hydronyme/trr2026/report/build_report/img/imageESP32-pinout-simple.png

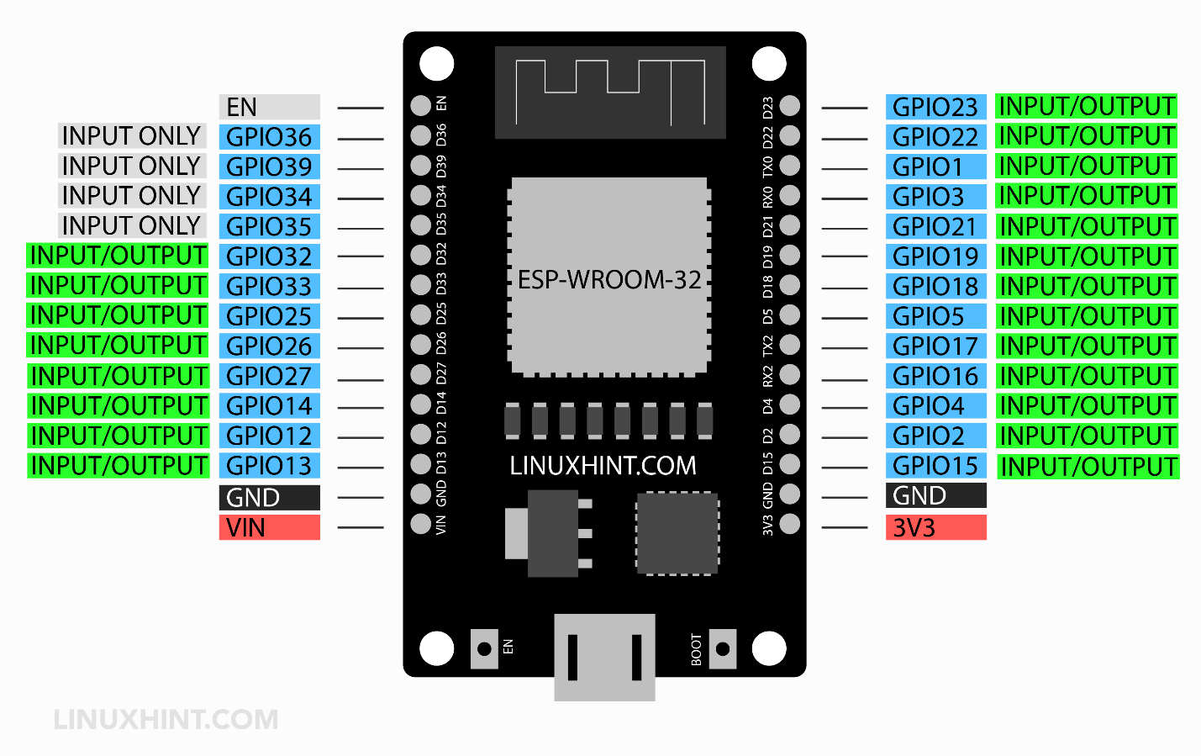
report/build_report/img/imageESP32-pinout-simple.png
