hydronyme/trr2026/report/build_report/img/L298N-DRIVER-pinout.jpg

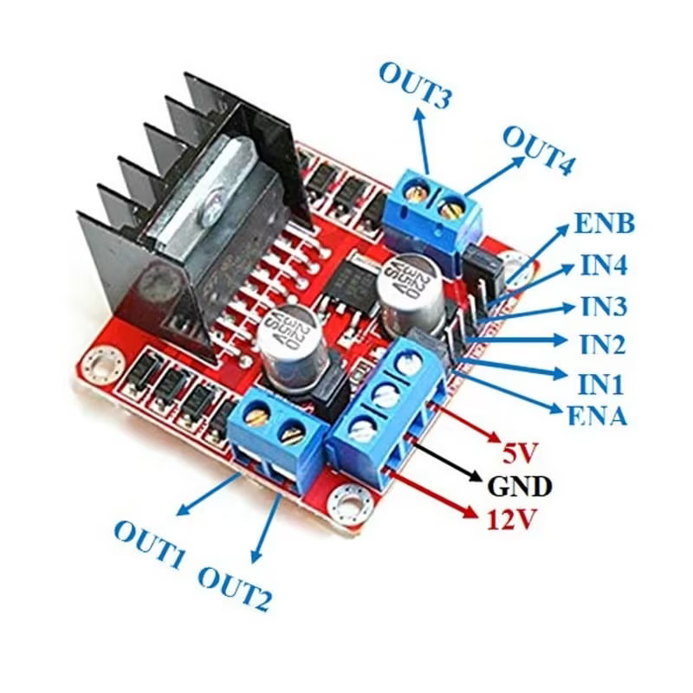
report/build_report/img/L298N-DRIVER-pinout.jpg
