hydronyme/trr2026/report/build_report/img/L298N-DRIVER-pinout.png

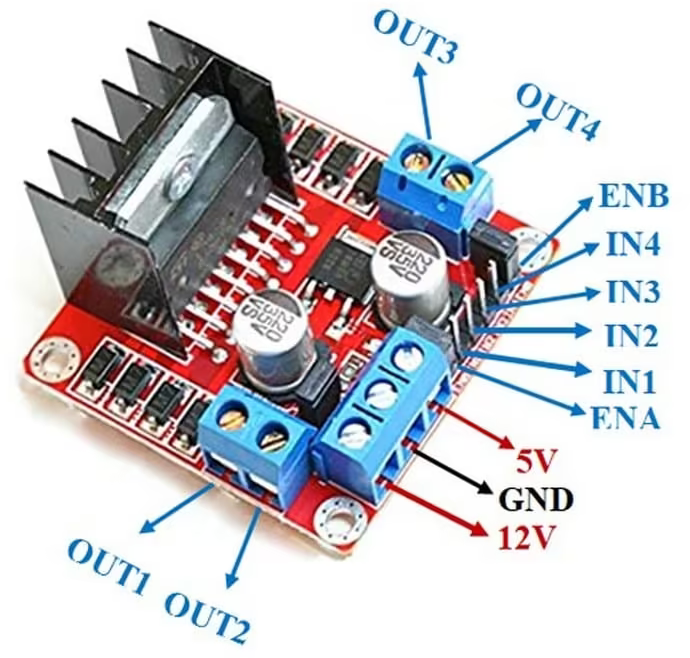
report/build_report/img/L298N-DRIVER-pinout.png
