hydronyme/trr2026/report/build_report/plan-projet.html

tout déplier

to do list

- programme de démarrage normal
- pilotage du pont H
- plaque de séparation et le positionnement de la caméra
- calculer l'homographie de la caméra
- carénage de la caméra
- carrenage de la voiture
- vérification mécanique de la direction rectiligne de la voiture
- utilisation de l'intelligence artificielle pour lire la ligne
- utilisation de l'intelligence artificielle pour les trajectoires dans les courbes.

done

- programme de démarrage via web
- programme d'arrêt via web
- piloter la vitesse via web

1. Conception générale de la voiture

Les composants à prendre en compte sont :

1. batterie propulsion 7,2V
2. moteur 7V ?
3. point H pour commande moteur
4. servo moteur 7V
5. compte tours 5V à 12V
6. esp32
7. batterie pour jetson orin nano 19V
8. régulateur de tension pour la jetson
9. jetson orin nano 19V



La dimension de plaque supérieure est 21.8 x 13.6

les composants de la voiture sont divisés en une partie basse et une partie haute

Dans la partie basse, on trouve la partie mécanique les composantes de propulsion et de direction

Dans la partie haute, on trouve la partie intelligente de la voiture.

2. Composants électroniques du niveau bas

2.1 Batterie moteur 7.2 V

Batterie 2S 7.2V Nimh

2.2 Servo Moteur pour la commande de direction : Hitec D-625MW HV

Dans la version initiale, le servo moteur était un KONECT 0913 LVMG 55G/9KG qui nécessitait une alimentation en 5V. Afin d'éviter un transformateur, il a été remplacé par un servo qui accepte directement la tension de la batterie 7,2 V.

2.2.1 Caractéristiques servo SRT Standard Servo (CL6030)

link (https://www.flashrc.com/fr/servos-rc-precision-fiabilite-pour-modelisme/24020-servo-digital-standard-hitec-d-625mw-hv-60g-10kgcm-013s-60-669962366250.html)
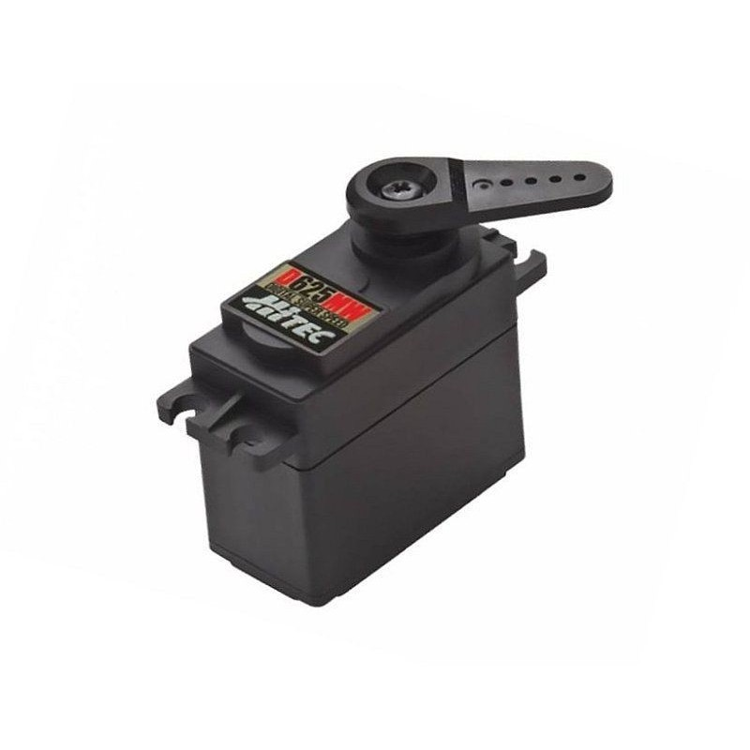
[picture p5: report/build_report/img/servo-digital-standard-hitec-d-625mw-hv-60g-10kgcm-013s-60.jpg]


Les servos ultra-rapides HS D-625MW HITEC D-Series offrent la plus haute résolution sur le marché aujourd'hui. Les meilleures possibilités de réponse et de programmation sont réalisées grâce au MCU 32 bits et à la technologie ADC 12 bits.La série 'D' regroupe les servos HITEC fonctionnant aussi bien en tension classique (4,8/6V) que HV (8,4V). Vous pourrez donc l'alimenter comme vous le souhaitez.Le servo numérique HS-625MW Digital est entièrement programmable et offre une bonne durabilité grâce à ses robustes engrenages en acier complets et à deux roulements à billes sur l'arbre de sortie, ce qui convient particulièrement lorsque le jeu faible et la haute précision de positionnement sont importants.La longue durée de vie et la transmission conçue de manière unique en font l'un des servos les plus fiables et les plus efficaces du marché.

Caractéristiques :

- Largeur: 20 mm
- Hauteur: 37 mm
- Longueur: 40 mm
- Poids: 60 gr
- Type de servo: standard
- Caractéristiques spéciales: large-tension numérique
- Type de moteur Servos: coreless
- Équipement: acier
- Tension de fonctionnement en V: 4.8-8.4 V
- Temps de fonctionnement s / 60 ° à 4,8 volts: 0,20
- Temps de fonctionnement s / 60 ° à 6,0 volts: 0,15
- Temps de fonctionnement s / 60 ° à 7.4 volts: 0.13
- Couple en kgcm à 4,8 volts: 6.3
- Couple en kgcm à 6,0 volts: 8.8
- Couple en kgcm à 7,4 volts: 10
- Denture: 25T
- Roulement à billes: oui
- Étanche: non

2.2.2 connexion Jetson

Signal PWM requis

Le servo standard attend :

Fréquence : 50 Hz (Période = 20 ms)

Impulsion :

~1 ms → 0°
~1.5 ms → 90°
~2 ms → 180°

code esp32

#include 

static const int servoPin = 18;

Servo servo1;

void setup() {

  Serial.begin(115200);
  servo1.attach(servoPin);
}

void loop() {
  for(int posDegrees = 0; posDegrees <= 180; posDegrees++) {
    servo1.write(posDegrees);
    Serial.println(posDegrees);
    delay(20);
  }

  for(int posDegrees = 180; posDegrees >= 0; posDegrees--) {
    servo1.write(posDegrees);
    Serial.println(posDegrees);
    delay(20);
  }
}

code jetson

import serial
import time

ser = serial.Serial('/dev/ttyUSB0', 115200)
time.sleep(2)

def set_angle(angle):
    cmd = f"{angle}\n"
    ser.write(cmd.encode())

set_angle(0)
time.sleep(2)
set_angle(90)
time.sleep(2)
set_angle(180)

2.3 Compte-tours

OMRON E6A2-CWZ3C Rotary Encoder.

- Red 5 to 12 V DC
- Black : 0V
- White: OUT A
- Green : OUT B
- Yellow : OUT Z

compte tours (https://www.ia.omron.com/product/item/2368/)

Rotary Encoder, Incremental, External Diameter: 25 dia., NPN open collector output, 200 P/R, 5 to 12 VDC, Phases A/B/Z, Pre-wired model, 2 m

2.4 Pilotage du moteur avec un Pont-H : BTS7980

Initialement, le pont H utilisé était un L298N mais l'intensité maximale de ce driver est limité à 2A, une valeur insuffisante pour le moteur qui peut tirer jusqu'à 10A.

Le pont en H BTS7980 permet de piloter un moteur qui nécessite beaucoup de courant. Cette carte est composée de 2 demi-pont en H BTS7960 qui permettent de supporter un courant jusqu'à 43A sous une tension entre 5,5V et 27V. Les signaux de commandes sont isolés par un 74HC244 et ce qui permet de le piloter aussi bien en 3,3V ou en 5V

Pin | Nom | Fonction
1 | RPMW | Forward Level, PWM signal actif à l'état haut
2 | LPWM | Reverse Level, PWM signal actif à l'état haut
3 | R_EN | Forward Enable, signal actif à l'état haut
4 | L_EN | Reverse Enable, signal actif à l'état haut
5 | R_IS | Forward Drive, sortie Alarme consommation
6 | L_IS | Reverse Drive, sortie Alarme consommation
7 | VCC | Alimentation +5V
8 | GND | Masse

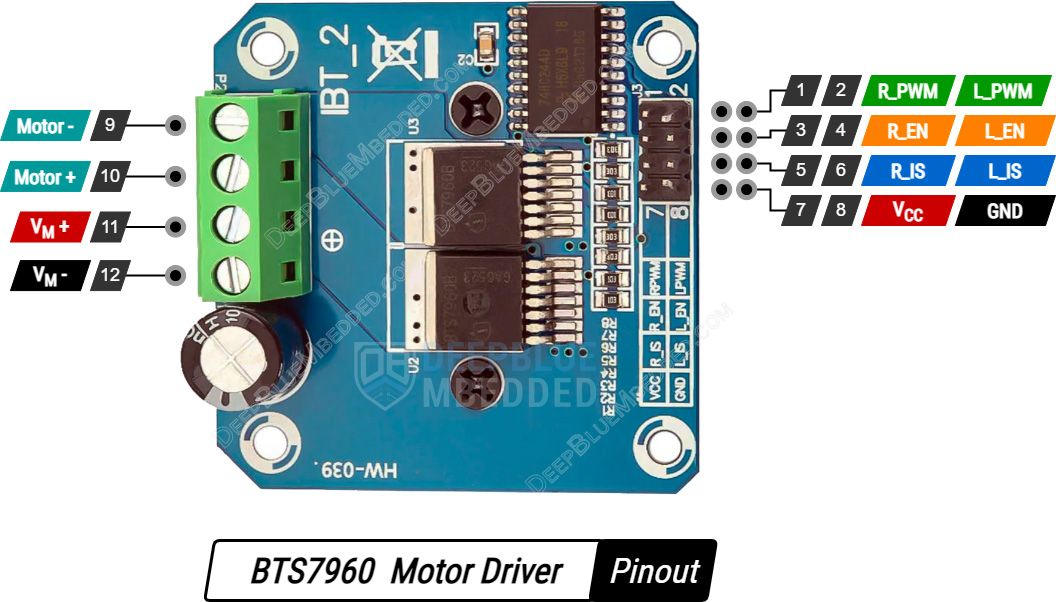
[picture p6: report/build_report/img/TBS7960-Pinout.jpg]


PIN 1 | PIN 2 | PINS 3 & 4 | Motor Output
PWM (20 kHz, 3.3V amplitude) | 0 volts | 3.3 volts | Variable speed Forward
0 volts | PWM (20 kHz, 3.3V amplitude) | 3.3 volts | Variable speed Reverse

2.4.1 Connexion entre L298N et ESP32

Connexion

L298N | ESP32
ENA | GPIO PWM (ex: 25)
IN1 | GPIO (ex: 26)
IN2 | GPIO (ex: 27)
GND | GND commun

Logique de commande

IN1 | IN2 | Action
1 | 0 | Sens 1
0 | 1 | Sens 2
0 | 0 | Stop
1 | 1 | Frein

Code Jetson

import serial
ser = serial.Serial('/dev/ttyUSB0', 115200)

ser.write(b'F100\n')  # Forward 100%
ser.write(b'B050\n')  # Backward 50%
ser.write(b'S\n')     # Stop

Code ESP32

/*
IBT-2 Motor Control Board driven by Arduino.
 
Speed and direction controlled by a potentiometer attached to analog input 0.
One side pin of the potentiometer (either one) to ground; the other side pin to +5V
 
Connection to the IBT-2 board:
IBT-2 pin 1 (RPWM) to Arduino pin 5(PWM)
IBT-2 pin 2 (LPWM) to Arduino pin 6(PWM)
IBT-2 pins 3 (R_EN), 4 (L_EN), 7 (VCC) to Arduino 5V pin
IBT-2 pin 8 (GND) to Arduino GND
IBT-2 pins 5 (R_IS) and 6 (L_IS) not connected
*/
 
int SENSOR_PIN = 0; // center pin of the potentiometer
 
int RPWM_Output = 5; // Arduino PWM output pin 5; connect to IBT-2 pin 1 (RPWM)
int LPWM_Output = 6; // Arduino PWM output pin 6; connect to IBT-2 pin 2 (LPWM)
 
void setup()
{
  pinMode(RPWM_Output, OUTPUT);
  pinMode(LPWM_Output, OUTPUT);
}
 
void loop()
{
  int sensorValue = analogRead(SENSOR_PIN);
 
  // sensor value is in the range 0 to 1023
  // the lower half of it we use for reverse rotation; the upper half for forward rotation
  if (sensorValue < 512)
  {
    // reverse rotation
    int reversePWM = -(sensorValue - 511) / 2;
    analogWrite(LPWM_Output, 0);
    analogWrite(RPWM_Output, reversePWM);
  }
  else
  {
    // forward rotation
    int forwardPWM = (sensorValue - 512) / 2;
    analogWrite(LPWM_Output, forwardPWM);
    analogWrite(RPWM_Output, 0);
  }
}

Micro-Python ESP32

from machine import UART
from dcmotor import DCMotor 
from machine import Pin, PWM
from time import sleep     
import time

frequency = 15000       
pin1 = Pin(5, Pin.OUT)    
pin2 = Pin(4, Pin.OUT)  
enable = PWM(Pin(18), frequency)  
dc_motor = DCMotor(pin1, pin2, enable)      
dc_motor = DCMotor(pin1, pin2, enable, 350, 1023)

while True:
    dc_motor.forward(100) # le moteur tourne
    time.sleep(1)
    dc_motor.stop() # stop le moteur
    time.sleep(1)
    dc_motor.backwards(100) # le moteur tourne dans le sens inverse
    time.sleep(1)
    dc_motor.stop() # stop le moteur
    time.sleep(1)

2.4.2 Alternatives

Alternatives modernes pour moteurs DC (brushed) 🔹 TB6612FNG 1,2 A par canal (3,2 A en pic) Très faible chute de tension (MOSFET) Compact, efficace 👉 Remplacement direct le plus courant du L298N 🔹 DRV8833 1,5 A par canal Fonctionne dès 2,7 V Très adapté aux petits robots et projets sur batterie 🔹 DRV8871 Jusqu’à 3,6 A Protection thermique et contre les surintensités Idéal moteurs DC plus puissants 🔹 BTS7960 Jusqu’à 43 A (module basé sur puce automobile) Pour moteurs 12 V / 24 V très puissants

2.5 Moteur propulsion : MST M54-26T

Moteur MST à balais M54-26T

- Tension : 6.0V~8.4V
- Régime : 17500 t/mn
- Couple : 264 g-cm

Quelle est la puissance du moteur ? Intensité en pointe jusqu'à 10 A
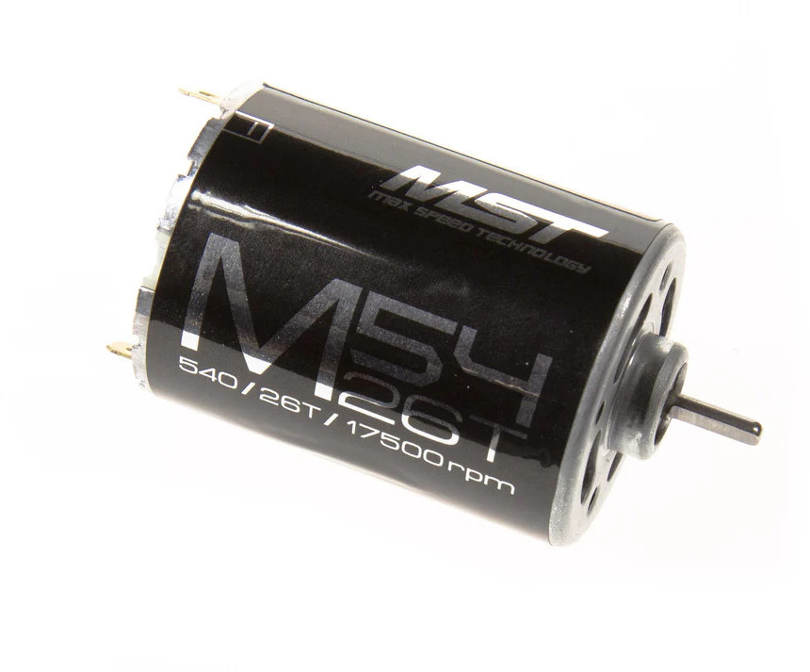
[picture p7: report/build_report/img/mst-moteur-charbon-m54-26t-601010.jpg]


2.6 ESP32

ELEGOO 2PCS ESP32 Carte de développement Type-C, 2,4 GHz WiFi + Bluetooth Dual Core Microcontrôleur pour Arduino, Support MicroPython, NodeMCU, AP/STA/AP+STA, Puce CP2102

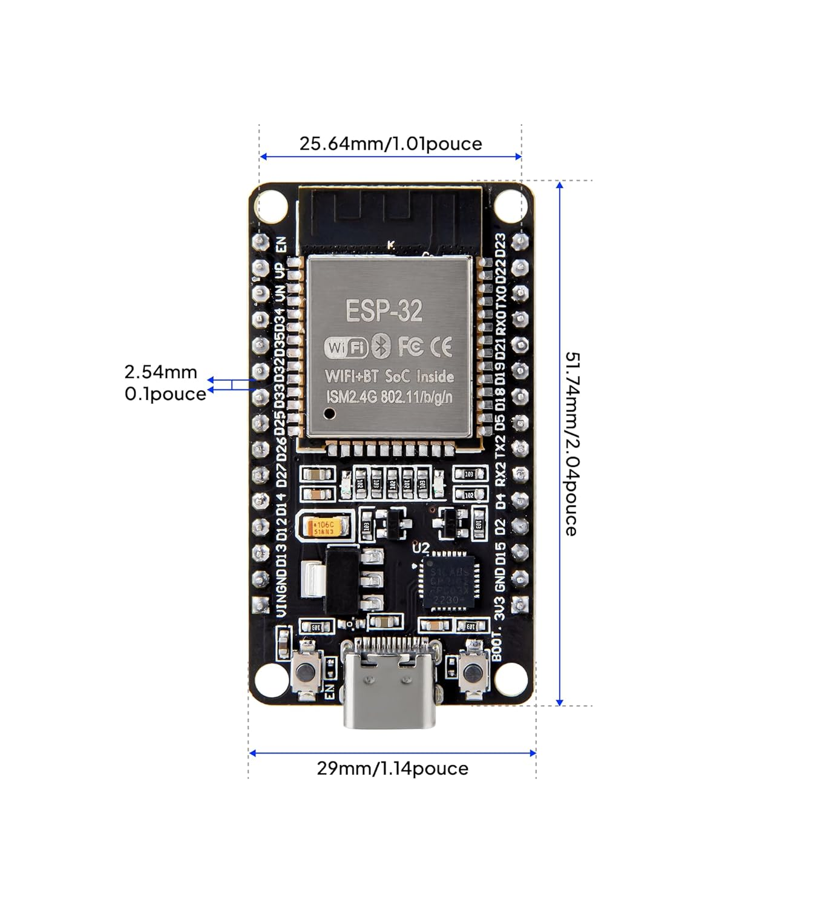
[picture p8: report/build_report/img/ESP32_71B7U8JGXAL._SL1500_.jpg]
ESP32 pin out (https://linuxhint.com/esp32-pinout-reference/) 


Capacités de traitement puissantes : la carte de développement ELEGOO ESP-WROOM-32 intègre un processeur 32 bits double cœur fonctionnant jusqu'à 240 MHz, offrant une puissance de traitement impressionnante. Connectivité sans fil : la carte de développement ESP-32S intègre des capacités Wi-Fi et Bluetooth, prenant en charge le Wi-Fi et le Bluetooth 2,4 GHz, permettant une large gamme d'options de communication et de connectivité sans fil. Efficacité énergétique : la puce présente une conception à faible consommation permettant un réglage dynamique de la puissance en mettant à l'échelle la fréquence d'horloge sur différents modes de fonctionnement. Cela rend la carte de développement adaptée aux appareils IoT (Internet des objets) alimentés par batterie. Interfaces périphériques polyvalentes : la carte de développement offre un riche ensemble d'interfaces périphériques, notamment GPIO, UART, SPI, I2C, etc., permettant une connectivité facile à une large gamme de capteurs. Prend en charge les mises à niveau du micrologiciel en direct : la puce ESP-WROOM-32 dispose de capacités de mise à niveau du micrologiciel en direct, permettant aux développeurs de continuer à mettre à jour et à optimiser le micrologiciel même après la sortie du produit.

Pour identifier la bonne configuration de l'ESP32 :
		./arduino-cli board listall esp32

Pour en connaître les détails :
		./arduino-cli board details --fqbn esp32:esp32:esp32

3. Composants électroniques du niveau haut

3.1 Batterie pour la jetson orin nano

alimentation en 19V de la jetson orin nano puissance max = 100 W Energie = Wh Chargeur Portable Power Bank, 30 000 MAh 65 W PD, Batterie Externe à Rapide avec Sortie 12 V 15 V 19 V DC, Sortie USB 5 V et Sortie de Type C pour Téléphone PC MP3 MP4 Marque : Depisuta Taille du produit : env. 16x7x4cm Poids brut : 870g Capacité réelle : 1 batterie au lithium 8650 30000mAh (incluse) Krisdonia 100W USB-C PD Batterie Externe pour Ordinateur Portable, Chargeur Portable 64000mAh [PD 3.0 + DC 12/16/20/24V + QC3.0] pour Ordinateur Portable, Tablette, Smartphone, projecteur et Plus Batterie externe améliorée 70 000 mAh, grande batterie externe, batterie externe pour téléphone portable PD 30 W, charge rapide, 5 sorties USB C et 2 entrées avec écran LED, chargeur portable pour Marque : Liahomco 1070 Grammes 22 x 15 x 4 centimètres CY Câble d'extension de charge Câble 100 W Type C USB-C Entrée vers 20 V DC 5,5 x 2,5 mm Puissance de sortie 20 V 5 A 65 W Câble de charge PD Compatible avec ordinateur portable

3.2 Régulateur de tension XL4016E1

Digital PWM Adjustable DC-DC Step down

version HW-263

The XL4016 is a 180KHz fixed frequency PWM buck (step-down) DC/DC converter, capable of driving an 8A load with high efficiency, low ripple, and excellent line and load regulation. This module helps you to power a high power load with stable voltage.

Features:

- Input Voltage: DC 4V ~ 38V
- Output Voltage: DC 1.25V ~ 36V
- Current: 8A (for long time: 5A)
- Switching Frequency: 180KHz
- Maximum power: 200W
- Conversion efficiency: 94%
- Short circuit protection

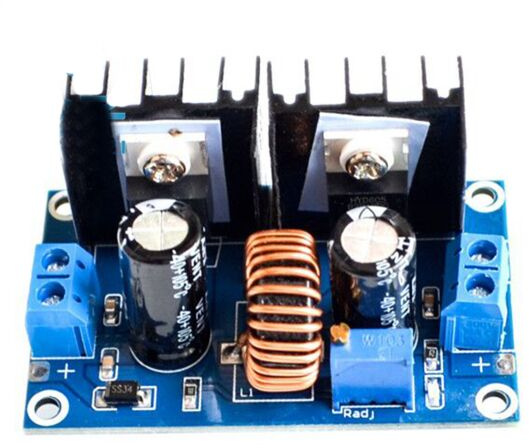
[picture p10: report/build_report/img/dc-dc_8a_buck_regulator_module_xl4016e1_1.jpg]


3.3 Caméra CSI

3.3.1 Description du produit : IMX219-D160

This is a camera module (without driver PCB) compatible with the official Raspberry Pi Camera Board V2, with 8-megapixel IMX219 sensor and features 160 degree field of view.

Camera specifications

    CMOS size : 1/4inch
    Aperture (F) : 2.35
    Focal Length : 3.15mm
    Angle of View (diagonal) : 160 degree
    Distortion: <14.3%
    Focusing Range: 20cm ~ infinity

3280 x2464 still picture resolution

Support 1080p30, 720p60 and 640x480p90 video record

3.3.2 Configuration de la caméra sur la Jetson Orin Nano

Pour configurer la caméra CSI

link1 (https://github.com/jetsonhacks/CSI-Camera/blob/master/README.md) link2 (https://docs.nvidia.com/jetson/archives/l4t-archived/l4t-3275/index.html)

La commande suivante devrait lister la caméra :

v4l2-ctl --list-devices

ffplay /dev/video0

3.3.3 Calibration d'image de la caméra

Dans le modèle du trou d'aiguille, on modélise la projection de l'espace réel vers la caméra par une droite qui passe par le trou d'aiguille et qui est aussi l'origine du repère. Son équation est définie par :

$$\left\{ \begin{array}{cl} x_v & = \ \frac{\beta_u}{\beta_v} \frac{u-u_O}{v-v_h} \\ y_v & = \ \ \beta_v \frac{1}{v-v_h} \end{array} \right. $$ $$\left\{ \begin{array}{cl} x & = \ a \times t \\ y & = \ b \times t \\ z & = \ c \times t \end{array} \right. $$

Le point de l'espace réel de coordonnées \((x_0,y_0,z_0)\) est associé par convention au paramètre \(t=1\). On a ainsi \((x_0=a,y_0=b,z_0=c)\). De plus, le point de l'espace réel se déplace sur un plan horizontal avec \(z_0=-h\). Ce point est projeté sur le plan focal de la caméra, sur le point de coordonnées \((x_1,y_1,z_1)\) avec \(x_1=-f\).

$$\left\{ \begin{array}{cl} -f & = \ x_0 \times t \\ y_1 & = \ y_0 \times t \\ z_1 & = \ -h \times t \end{array} \right. $$

Ainsi, on peut retrouver la position du point dans le monde réel à partir de la position dans la caméra :

$$\left\{ \begin{array}{cl} x_0 & = \ \frac{h \times f}{z_1} \\ y_0 & = \ - h \times \frac{y_1}{z_1} \end{array} \right. $$

Pour calibrer la caméra, on se sert de la largeur connue de la ligne blanche.

On connaît la dimension de la ligne blanche. Ainsi, il est possible de calibrer la caméra par homographie.

La plupart des caméras suivent le modèle de caméra à trou d’aiguille (pinhole). 
Dans ce modèle, un point 3D (X,Y,Z) est projeté sur un point image (x,y), selon la relation :
x=f X/Z et y=fY/Z où f est la distance focale.

On approxime la ligne détectée par un polynôme : x(y)=ay^2+by+c

Le rayon de courbure R est :

R=(1+(2ay+b)2)^(3/2)  / |2a|
	
On le calcule généralement en bas de l’image (proche du véhicule).

https://fr.wikipedia.org/wiki/Calibration_de_caméra

Transformation en vue "Bird's Eye View" (vue du dessus)

3.4 Bouton d'arrêt d'urgence

Interrupteur à levier ou à bascule On / Off / On double circuits avec six borniers à vis

3.5 Jetson Orin Nano Developer Kit

flasher avec NVIDIA SDK Manager
installer firefox avec sudo apt install firefox
installer isaac ROS (release 3-2)

4. Schémas électrique



https://docs.easyeda.com/en/

schéma électrique de l'installation

Connexion :

- Rouge → +5 V du BEC
- Noir → GND commun (BEC + Arduino)
- Jaune → Pin digitale Arduino (ex: D9)

https://www.tinkercad.com/

5. Programmation

5.1 jetson

https://developer.nvidia.com/sdk-manager https://developer.nvidia.com/embedded/jetpack-archive

5.2 arduino CLI

https://docs.arduino.cc/arduino-cli/installation/#download https://dev.to/stepanvrany/esp32-with-arduino-cli-36mh

5.3 ROS2

https://docs.ros.org/en/humble/Tutorials/Beginner-Client-Libraries/Creating-Your-First-ROS2-Package.html

5.4 architecture de contrôle



Architecture de contrôle typique
Option simple :

Jetson envoie PWM directement.

Option robuste (recommandée) :

Jetson envoie :

position cible

vitesse cible

ESP32 calcule :

PID moteur

position via codeur

PWM réel

👉 Beaucoup plus stable.

5.5 code ESP32

/************************************************************
  ESP32 Firmware
  Servo + L298N + Encoder + PID
************************************************************/

// ================= GPIO =================
#define SERVO_PIN 18

#define MOTOR_PWM_PIN 25
#define MOTOR_IN1     26
#define MOTOR_IN2     27

#define ENC_A 34
#define ENC_B 35

// ================= PWM =================
#define SERVO_CH 0
#define MOTOR_CH 1

#define SERVO_FREQ 50
#define MOTOR_FREQ 20000

#define PWM_RES_SERVO 16
#define PWM_RES_MOTOR 10

// ================= Encoder =================
volatile long encoderCount = 0;

// ================= PID =================
float Kp = 1.2;
float Ki = 0.0;
float Kd = 0.02;

float targetPosition = 0;
float integral = 0;
float previousError = 0;

float output = 0;
const float integralLimit = 10000;

unsigned long lastPID = 0;
const int PID_INTERVAL = 5; // ms

// ================= Encoder ISR =================
void IRAM_ATTR handleEncoderA() {
  if (digitalRead(ENC_A) == digitalRead(ENC_B))
    encoderCount++;
  else
    encoderCount--;
}

// ================= Servo =================
void setServoAngle(int angle) {
  angle = constrain(angle, 0, 180);

  // 1ms -> 3277 ; 2ms -> 6553 (16 bits @ 20ms period)
  uint32_t duty = map(angle, 0, 180, 3277, 6553);
  ledcWrite(SERVO_CH, duty);
}

// ================= Motor =================
void setMotorOutput(float pwm) {
  pwm = constrain(pwm, -1023, 1023);

  if (pwm > 0) {
    digitalWrite(MOTOR_IN1, HIGH);
    digitalWrite(MOTOR_IN2, LOW);
    ledcWrite(MOTOR_CH, pwm);
  } else if (pwm < 0) {
    digitalWrite(MOTOR_IN1, LOW);
    digitalWrite(MOTOR_IN2, HIGH);
    ledcWrite(MOTOR_CH, -pwm);
  } else {
    digitalWrite(MOTOR_IN1, LOW);
    digitalWrite(MOTOR_IN2, LOW);
    ledcWrite(MOTOR_CH, 0);
  }
}

// ================= PID =================
void updatePID() {
  float position = encoderCount;
  float error = targetPosition - position;

  integral += error;
  integral = constrain(integral, -integralLimit, integralLimit);

  float derivative = error - previousError;

  output = Kp * error + Ki * integral + Kd * derivative;

  output = constrain(output, -1023, 1023);

  setMotorOutput(output);

  previousError = error;
}

// ================= Serial Parser =================
void parseCommand(String cmd) {
  cmd.trim();

  if (cmd.startsWith("S,")) {
    int angle = cmd.substring(2).toInt();
    setServoAngle(angle);
  }

  else if (cmd.startsWith("M,")) {
    targetPosition = cmd.substring(2).toFloat();
  }

  else if (cmd.startsWith("P,")) {
    int first = cmd.indexOf(',');
    int second = cmd.indexOf(',', first + 1);
    int third = cmd.indexOf(',', second + 1);

    Kp = cmd.substring(first + 1, second).toFloat();
    Ki = cmd.substring(second + 1, third).toFloat();
    Kd = cmd.substring(third + 1).toFloat();
  }

  else if (cmd == "STOP") {
    setMotorOutput(0);
  }

  else if (cmd == "R") {
    Serial.print("POS:");
    Serial.print(encoderCount);
    Serial.print(",OUT:");
    Serial.println(output);
  }
}

// ================= Setup =================
void setup() {

  Serial.begin(115200);

  pinMode(MOTOR_IN1, OUTPUT);
  pinMode(MOTOR_IN2, OUTPUT);

  pinMode(ENC_A, INPUT_PULLUP);
  pinMode(ENC_B, INPUT_PULLUP);

  attachInterrupt(digitalPinToInterrupt(ENC_A), handleEncoderA, CHANGE);

  // Servo PWM
  ledcSetup(SERVO_CH, SERVO_FREQ, PWM_RES_SERVO);
  ledcAttachPin(SERVO_PIN, SERVO_CH);

  // Motor PWM
  ledcSetup(MOTOR_CH, MOTOR_FREQ, PWM_RES_MOTOR);
  ledcAttachPin(MOTOR_PWM_PIN, MOTOR_CH);

  lastPID = millis();
}

// ================= Loop =================
void loop() {

  if (Serial.available()) {
    String cmd = Serial.readStringUntil('\n');
    parseCommand(cmd);
  }

  if (millis() - lastPID >= PID_INTERVAL) {
    updatePID();
    lastPID = millis();
  }
}

5.5 démarrage / arrêt de la course

sudo nano /etc/systemd/system/ros2_start.service [Unit] Description=ROS2 Startup Service After=network.target [Service] User=ton_user ExecStart=/bin/bash -c "source /opt/ros/humble/setup.bash && source /home/ton_user/ros2_ws/install/setup.bash && ros2 run mon_package mon_executable" Restart=always [Install] WantedBy=multi-user.target sudo systemctl daemon-reexec sudo systemctl daemon-reload sudo systemctl enable ros2_start.service sudo systemctl start ros2_start.service journalctl -u ros2_start.service -f

5.6 utiliation de l'IA pour l'analyse des images

Comment utiliser l'intelligence artificielle pour analyser dans les images d'une caméra la position d'une ligne blanche large de 5 cm ?

5.7 optimisation de la jetson

Run the following command to set the to power to MAX settings. See Power Mode Controls for more details.

sudo /usr/sbin/nvpmodel -m 0

pour désactiver le sommeil du wifi :
sudo iw dev wlP1p1s0 set power_save off

6. Chassis

protection contre les chocs de la jetson
