hydronyme/trr2026/report/build_report/svg-inkscape/schema_electrique_svg-tex.pdf

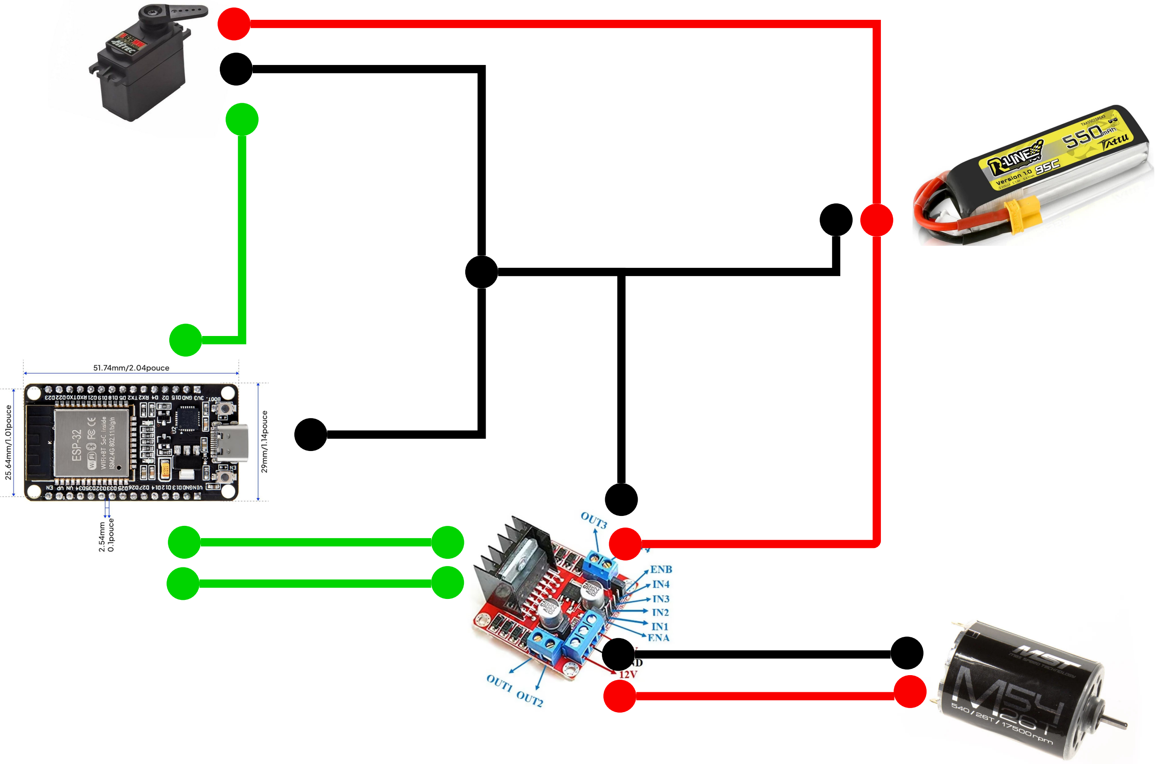
[picture p11: figure]
