hydronyme/trr2026/report/build_report/img/20260219_151313.jpg

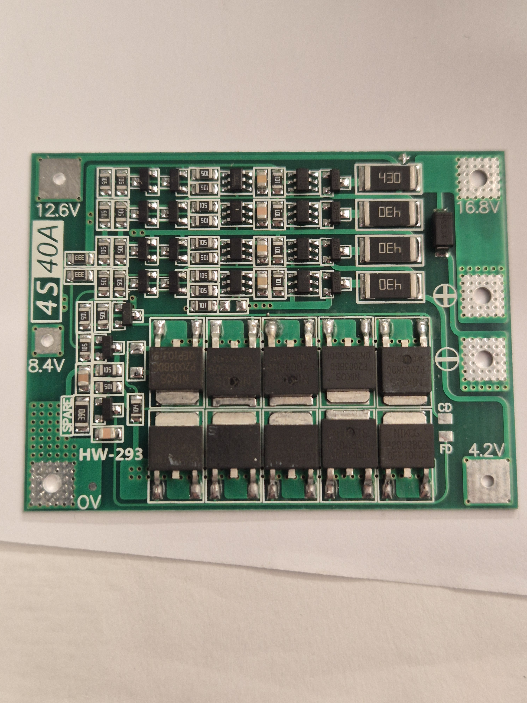
report/build_report/img/20260219_151313.jpg
