hydronyme/trr2026/report/build_report/img/1000032674.jpg

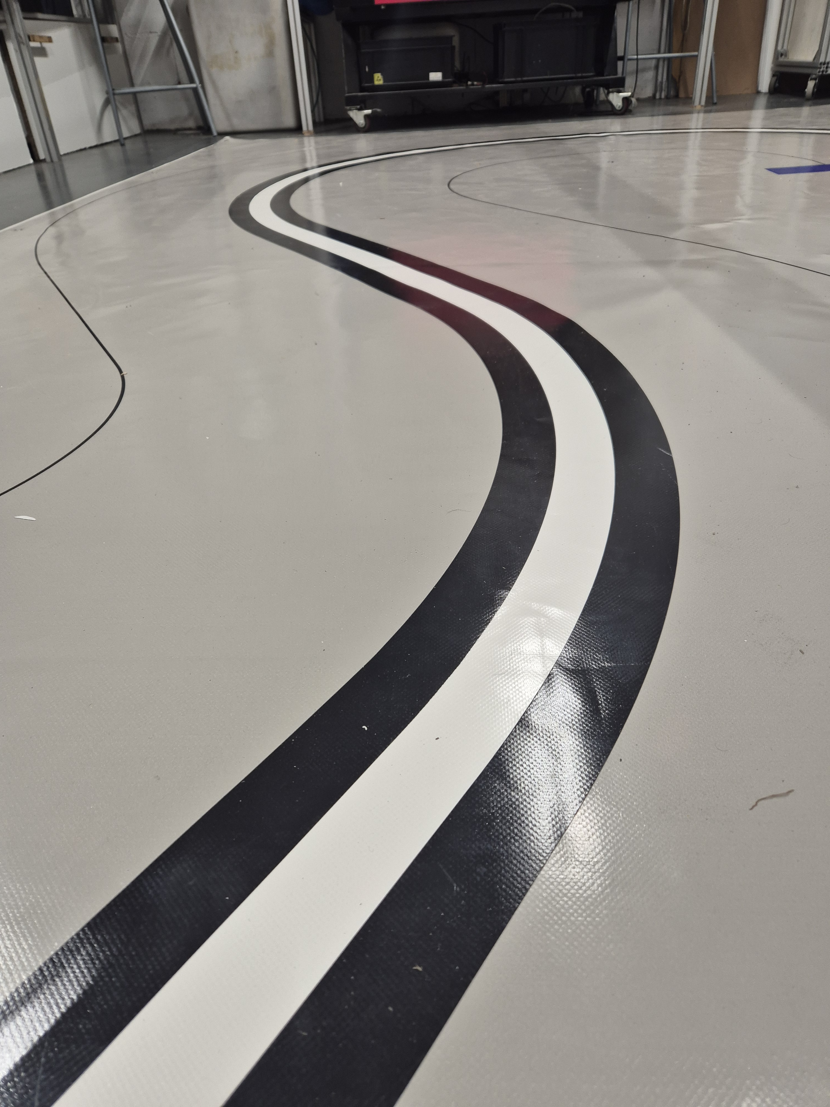
report/build_report/img/1000032674.jpg
