hydronyme/trr2026/report/build_report/img/1000036650.jpg

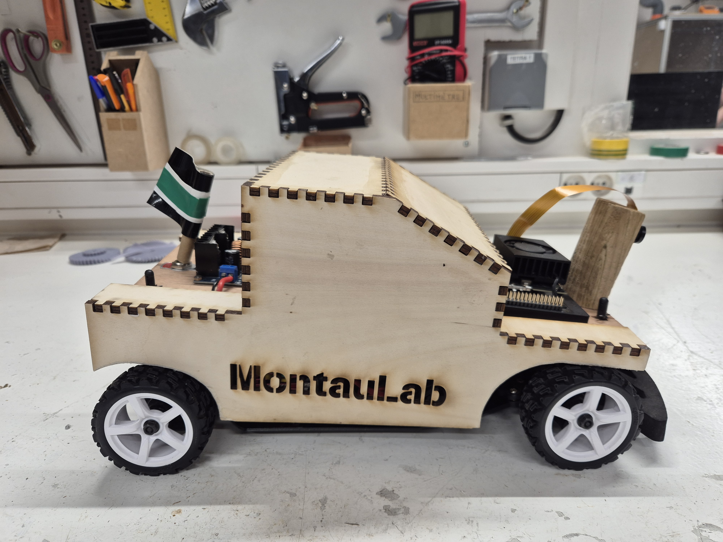
report/build_report/img/1000036650.jpg
