hydronyme/trr2026/report/build_report/img/batterie 7.2V.jpg

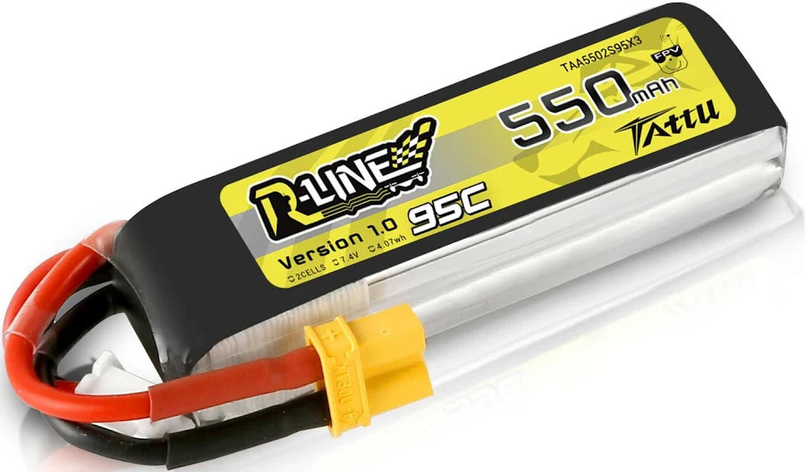
report/build_report/img/batterie 7.2V.jpg
