hydronyme/trr2026/report/build_report/img/driver-de-moteur-haute-puissance-bts7960-43a.jpg

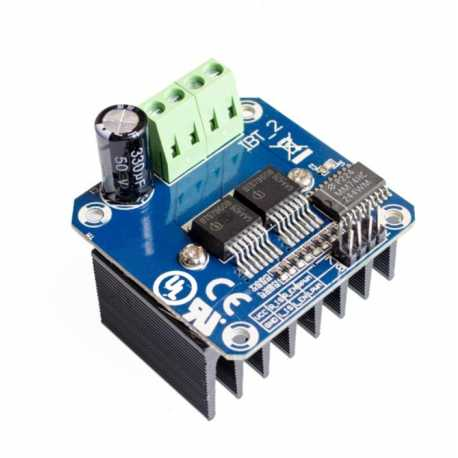
report/build_report/img/driver-de-moteur-haute-puissance-bts7960-43a.jpg
