hydronyme/trr2026/report/build_report/img/ESP32.jpg

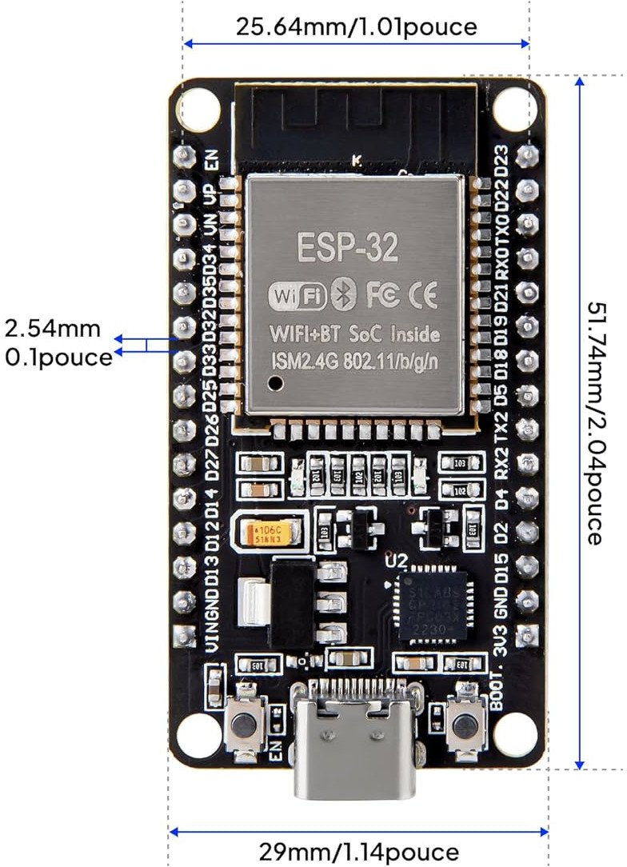
report/build_report/img/ESP32.jpg
