hydronyme/trr2026/report/build_report/img/IMG-20260606-WA0001.jpg

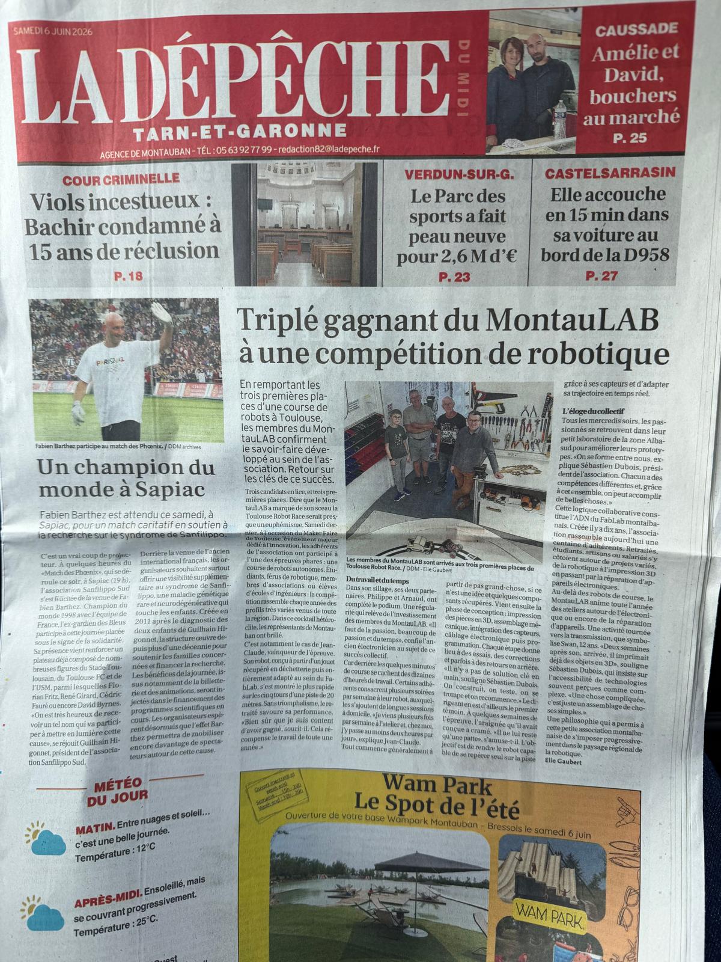
report/build_report/img/IMG-20260606-WA0001.jpg
