hydronyme/trr2026/report/build_report/img/interrupteur_heschen.jpg

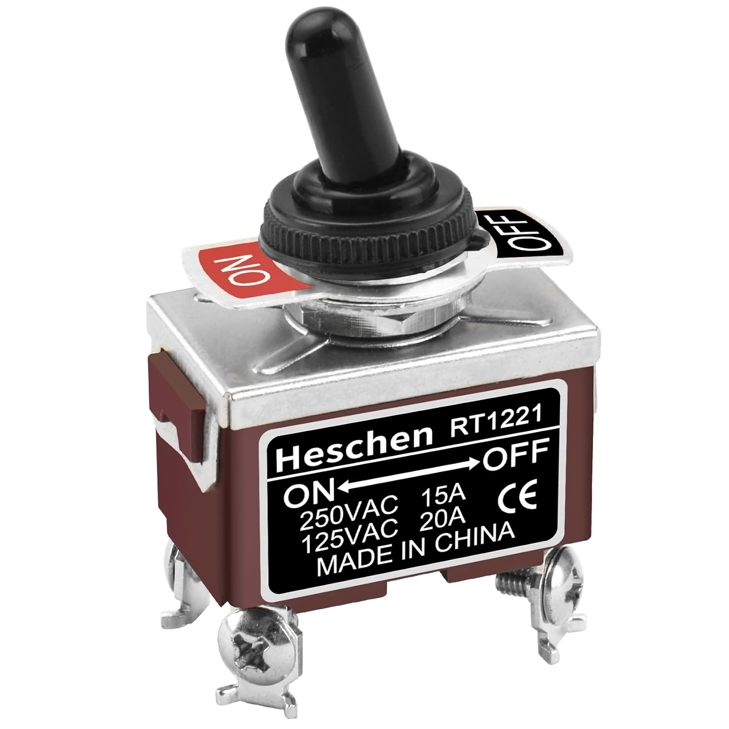
report/build_report/img/interrupteur_heschen.jpg
