hydronyme/trr2026/report/build_report/img/jetson orin nano.jpg

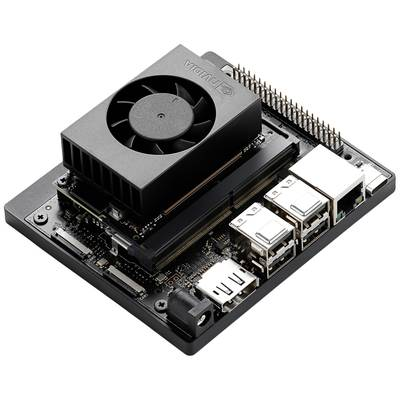
report/build_report/img/jetson orin nano.jpg
