hydronyme/trr2026/report/build_report/img/module-L298N-arduino-branchement-borne-alimentation-commande.jpg

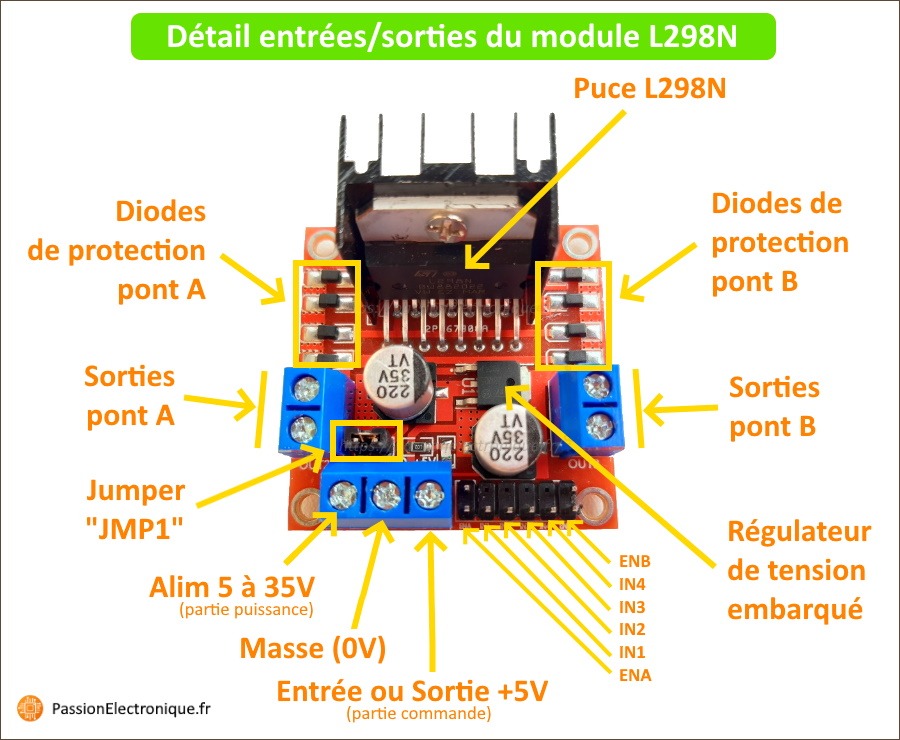
report/build_report/img/module-L298N-arduino-branchement-borne-alimentation-commande.jpg
