hydronyme/trr2026/report/build_report/img/onshape.png

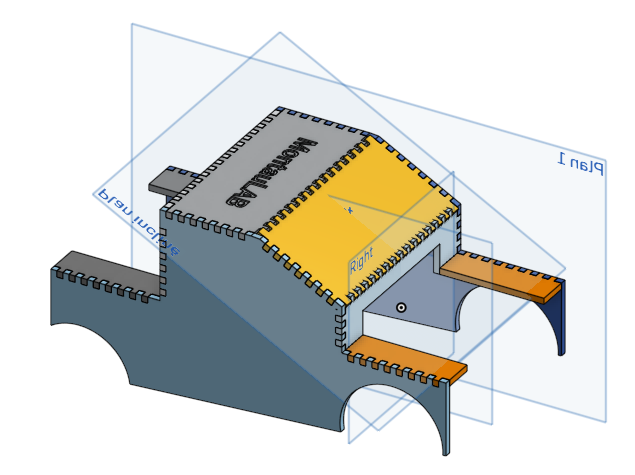
report/build_report/img/onshape.png
