hydronyme/trr2026/report/build_report/img/schema_camera.png

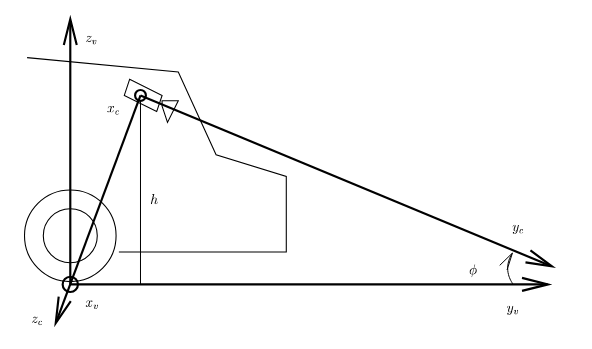
report/build_report/img/schema_camera.png
