hydronyme/trr2026/report/build_report/img/servo-srt-cl6030.jpg

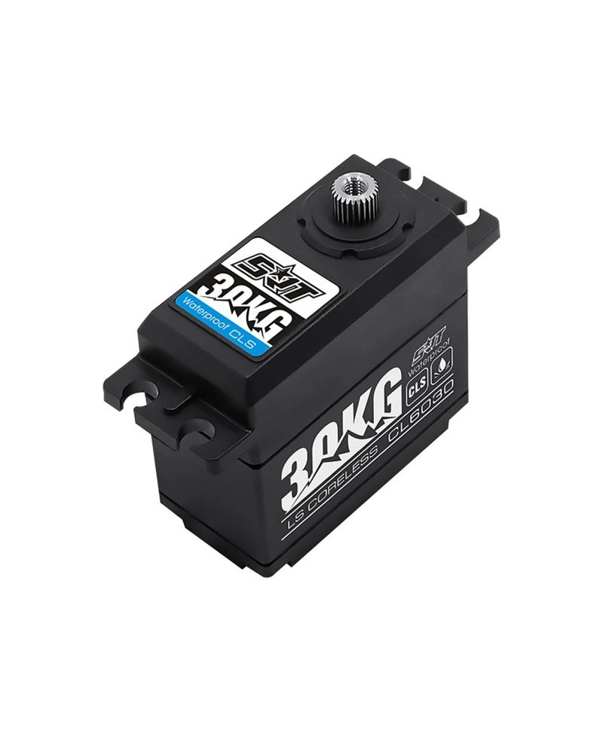
report/build_report/img/servo-srt-cl6030.jpg
