hydronyme/trr2026/report/build_report/svg-inkscape/carosserie_svg-tex.pdf

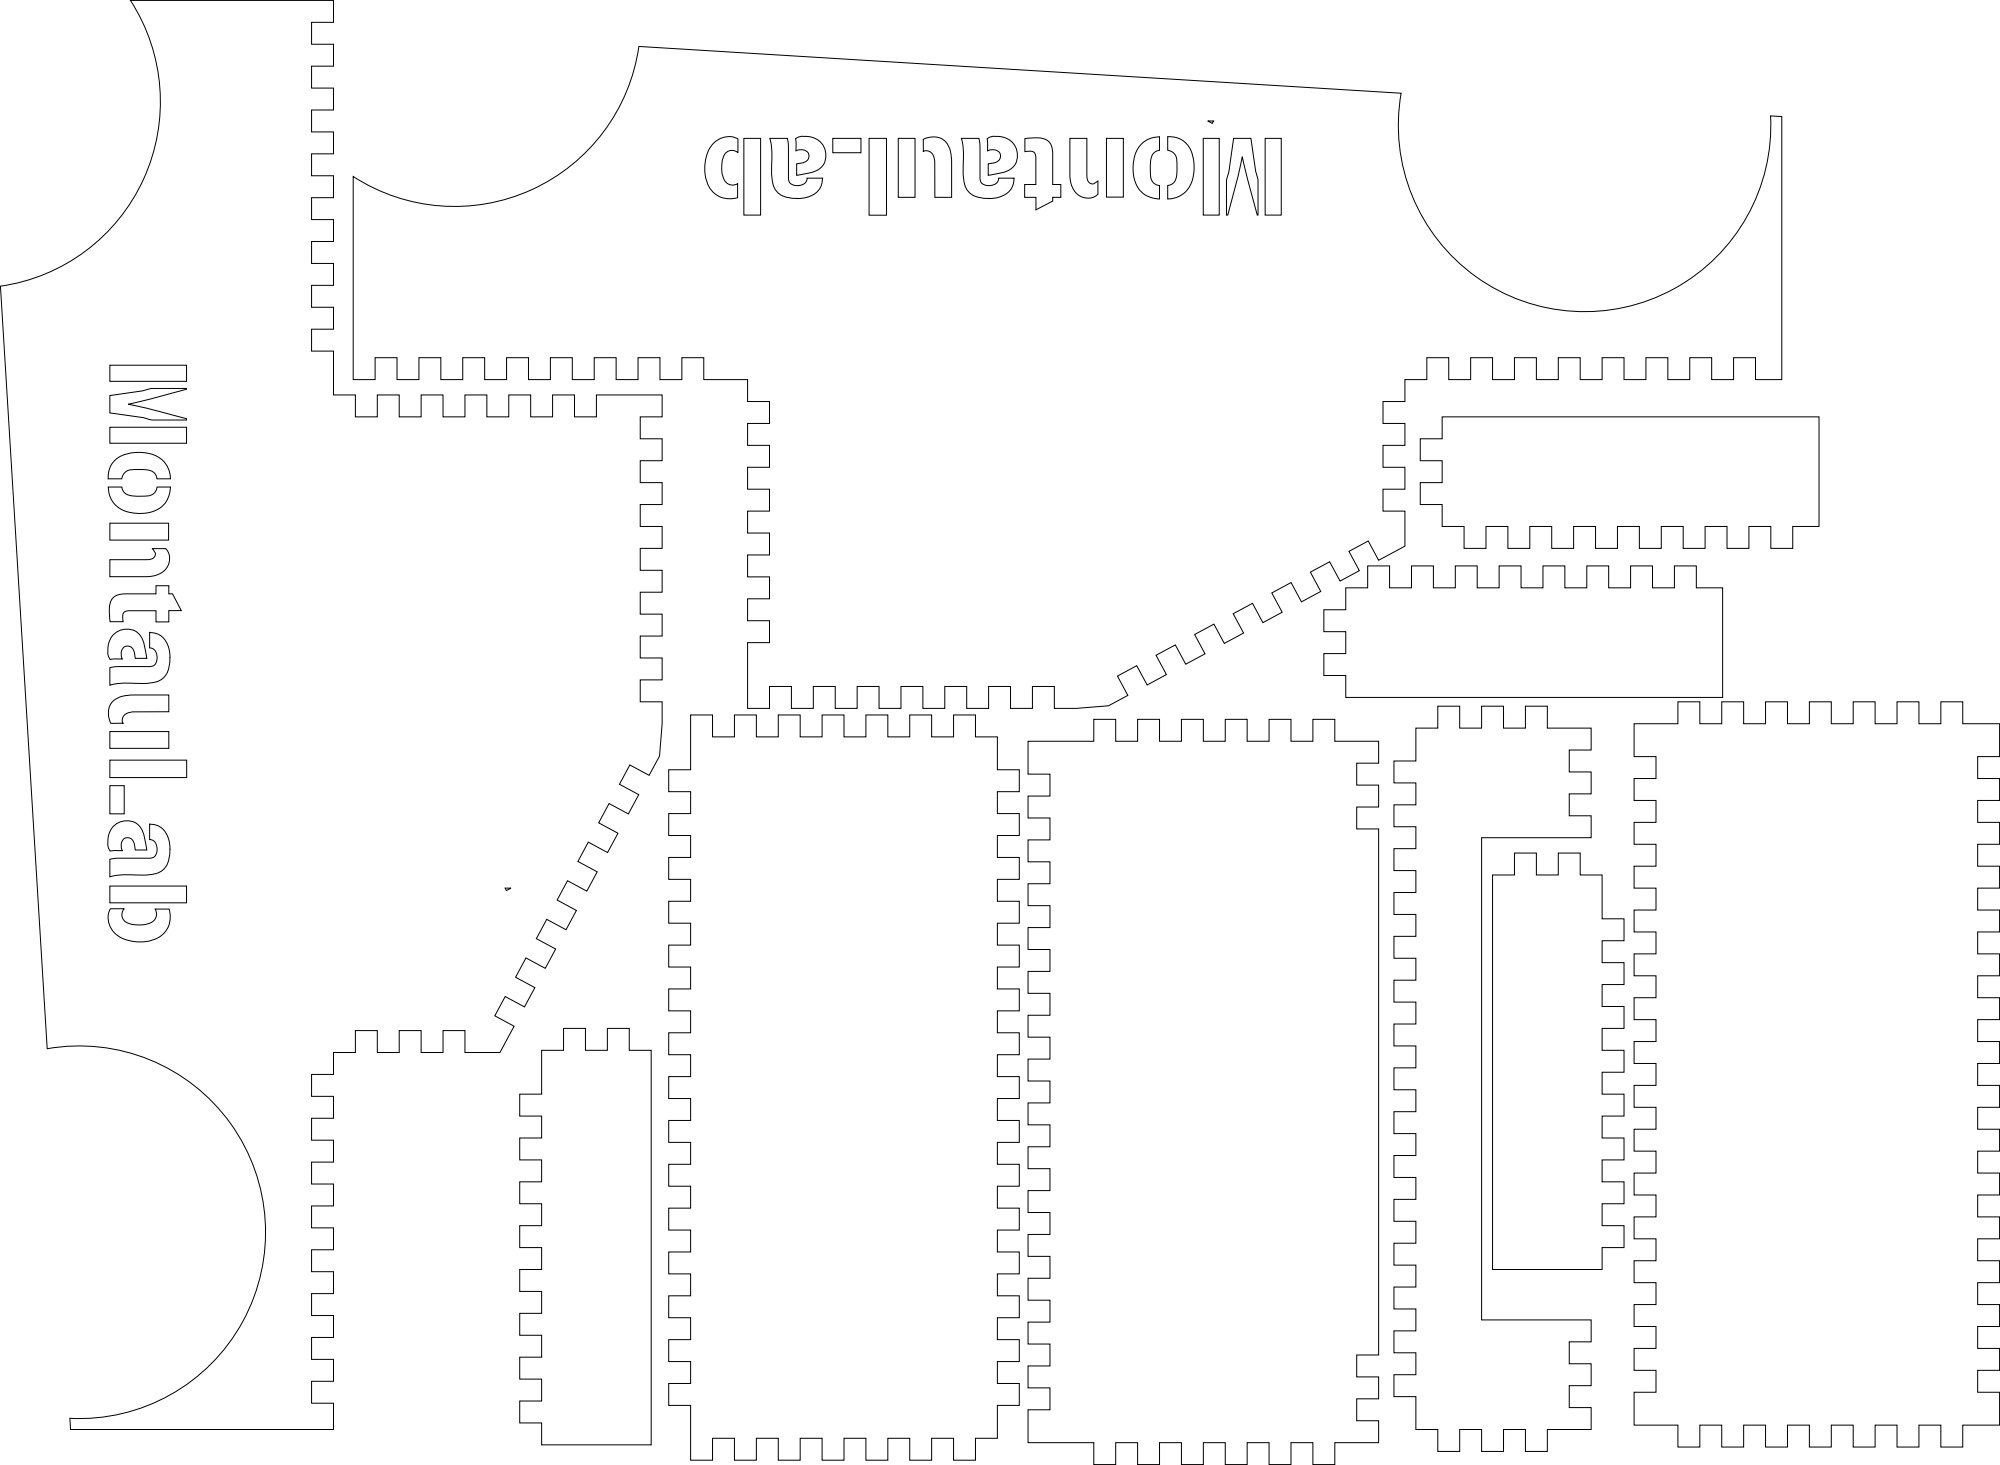
[picture p29: page 1]
