hydronyme/trr2026/src/pilot04.ino

// https://espressif-docs.readthedocs-hosted.com/projects/arduino-esp32/en/latest/api/ledc.html 
#include <ESP32Servo.h>

#define SERVO_PIN 32

#define RPWM 25
#define LPWM 26
#define REN  27
#define LEN  14

// Encodeur
#define ENCODER_A 18
#define ENCODER_B 19

Servo servo1;

// ---------- PWM ----------
#define PWM_CHANNEL_R 0
#define PWM_CHANNEL_L 1
#define PWM_FREQ      20000
#define PWM_RESOLUTION 8

// ---------- Encodeur ----------
volatile long encoderCount = 0;

// Adapter selon ton encodeur
// Exemple : 200 P/R en x2
const int COUNTS_PER_REV = 600;

// ---------- Régulation ----------
float targetRPM = 0.;
float currentRPM = 0.;

float Kp = 0.2;

int pwmOutput = 0;
float filteredRPM = 0;

long lastCount = 0;
uint32_t lastTime = 0;

// ---------- Sens ----------
bool forwardDirection = true;
bool stop_mode = true;

typedef struct __attribute__((packed)) {
    uint32_t time;
    uint32_t lastTime;
    long count;
    long lastCount;
    float currentRPM;
    float targetRPM;
    int lastPwm;
    int currentPwm;
} imu_packet_t;

imu_packet_t pkt;

/*
Pour un robot mobile (à deux ou quatre roues), une bonne fréquence de la boucle de contrôle est généralement comprise entre 100 et 500 Hz, 
tandis que les communications peuvent fonctionner à 10 à 50 Hz sans pénaliser les performances.
Cela offre une bonne séparation entre les tâches critiques et les tâches de service.
*/

void TaskControl(void *pvParameters) {
    while (true) {

        // Lecture capteurs
        // PID
        // Commande moteurs

        long count = encoderCount;
        long delta = count - lastCount;
        currentRPM = delta;

        uint32_t now = millis();
        pkt.time = now;
        pkt.lastTime = lastTime;
        pkt.count = count;
        pkt.lastCount = lastCount;
        pkt.currentRPM = currentRPM;
        pkt.targetRPM = targetRPM;
        pkt.lastPwm = pwmOutput;

        if (!forwardDirection) currentRPM = -currentRPM;

        //filteredRPM = 0.8 * filteredRPM + 0.2 * currentRPM;

        if (currentRPM == 0) {
            pwmOutput += 1;
            pwmOutput = constrain(pwmOutput, 0, 100);
        }
        else {
            //float correction = 0.5 * (targetRPM - filteredRPM);
            float correction = (targetRPM - currentRPM);
            correction = constrain(correction, -1, 1);
            pwmOutput += correction;
            pwmOutput = constrain(pwmOutput, 0, 100);
        }
        pkt.currentPwm = pwmOutput;

        // appliquer PWM
        if (forwardDirection)
        {
            ledcWrite(RPWM, pwmOutput);
            ledcWrite(LPWM, 0);
        }
        else
        {
            ledcWrite(RPWM, 0);
            ledcWrite(LPWM, pwmOutput);
        }

        Serial.write((uint8_t*)&pkt, sizeof(pkt));

        lastCount = count;
        lastTime = now;
    }
}

void TaskCommunication(void *pvParameters) {
    String cmd;
    String lastMessage;
    bool newMessage = false;

    while (true) {

        while (Serial.available())
        {
            lastMessage = Serial.readStringUntil('\n');
            newMessage = true;
        }
        if (newMessage) {
            newMessage = false;
            cmd = lastMessage;
            int separatorIndex = cmd.indexOf(':');
            if (separatorIndex != -1)
            {
                String commande = cmd.substring(0, separatorIndex);
                String valeur = cmd.substring(separatorIndex + 1);

                if (commande == "a") {
                    int angle = valeur.toInt();
                    setAngle(angle);
                }

                if (commande == "f") {
                    float rpm = valeur.toFloat();
                    stop_mode = false;
                    setForwardRPM(rpm);
                }

                if (commande == "b") {
                    float rpm = valeur.toFloat();
                    stop_mode = false;
                    setBackwardRPM(rpm);
                }

                if (commande == "s") {
                    stopMotor();
                }
            }
        }
    }
}

// ======================================================
// INTERRUPTION ENCODEUR
// ======================================================

void IRAM_ATTR handleEncoder()
{
    bool a = digitalRead(ENCODER_A);
    bool b = digitalRead(ENCODER_B);

    if (a != b)
        encoderCount++;
    else
        encoderCount--;
}

// ======================================================
// SETUP
// ======================================================

void setup()
{
    Serial.begin(115200);

    // Servo
    servo1.attach(SERVO_PIN);

    // Enable moteur
    pinMode(RPWM, OUTPUT);
    pinMode(LPWM, OUTPUT);
    pinMode(REN, OUTPUT);
    pinMode(LEN, OUTPUT);

    digitalWrite(REN, HIGH);
    digitalWrite(LEN, HIGH);

    // PWM hardware ESP32
    ledcAttach(RPWM, PWM_FREQ, PWM_RESOLUTION);
    ledcAttach(LPWM, PWM_FREQ, PWM_RESOLUTION);

    // Encodeur
    pinMode(ENCODER_A, INPUT_PULLUP);
    pinMode(ENCODER_B, INPUT_PULLUP);

    xTaskCreatePinnedToCore( TaskControl, "Control", 4096, NULL, 3, NULL, 1);   // cœur 1
    xTaskCreatePinnedToCore( TaskCommunication, "Comm", 4096, NULL, 1, NULL, 0);   // cœur 0

    attachInterrupt(digitalPinToInterrupt(ENCODER_A), handleEncoder, CHANGE);
    lastTime = millis();
}

// ======================================================
// DIRECTION
// ======================================================

void setAngle(int angle)
{
    int alpha = 90 + 10 + angle;
    servo1.write(alpha);
}

// ======================================================
// CONSIGNE VITESSE
// ======================================================

void setForwardRPM(float rpm)
{
    targetRPM = rpm;
    forwardDirection = true;
    stop_mode = false;
}

void setBackwardRPM(float rpm)
{
    targetRPM = rpm;
    forwardDirection = false;
    stop_mode = false;
}

void stopMotor()
{
    targetRPM = 0;

    ledcWrite(RPWM, 0);
    ledcWrite(LPWM, 0);
    stop_mode = true;
}

// ======================================================
// LOOP
// ======================================================

void loop()
{

}
