hydronyme/trr2026/src/test01.ino

#include <Adafruit_Sensor.h>
#include <DHT.h>
#include <Adafruit_GFX.h>
#include <Adafruit_SSD1306.h>
// Declaration for an SSD1306 display connected to I2C (SDA, SCL pins)
#include <Wire.h>
#define SCREEN_HEIGHT 64 // OLED display height, in pixels
#define SCREEN_WIDTH 128 // OLED display width, in pixels
Adafruit_SSD1306 display(SCREEN_WIDTH, SCREEN_HEIGHT, &Wire, -1);

#define DHTPIN 4     // Digital pin connected to the DHT sensor

// Uncomment the type of sensor in use:
#define DHTTYPE    DHT11     // DHT 11

DHT dht(DHTPIN, DHTTYPE);

String readDHTTemperature() {
  // Sensor readings may also be up to 2 seconds 'old' (its a very slow sensor)
  // Read temperature as Celsius (the default)
  float t = dht.readTemperature();
  // Check if any reads failed and exit early (to try again).
  if (isnan(t)) {    
    Serial.println("Failed to read from DHT sensor!");
  }
  else {
    Serial.printf("temperature:%f\n",t);
    String s;
    //s = "T°" + std::to_string(t);
    display.println(t);
    display.display(); 

  }
  return "toto";
}

String readDHTHumidity() {
  // Sensor readings may also be up to 2 seconds 'old' (its a very slow sensor)
  float h = dht.readHumidity();
  if (isnan(h)) {
    Serial.println("Failed to read from DHT sensor!");
  }
  else {
    Serial.printf("humidite:%f\n",h);
    display.println(h);
    display.display(); 
  }
  return "toto";
}


void setup() {
  Serial.begin(115200);
  dht.begin();
  if(!display.begin(SSD1306_SWITCHCAPVCC, 0x3C)) 
  { 
    Serial.println(F("SSD1306 allocation failed"));
    for(;;);
  }
  delay(2000);
  display.clearDisplay();
  display.setTextSize(2);
  display.setTextColor(WHITE);
  display.setCursor(0, 30);

}

void loop() {
  // put your main code here, to run repeatedly:
  readDHTTemperature();
  readDHTHumidity();
  delay(5000);
  display.clearDisplay();
  display.setTextSize(2);
  display.setTextColor(WHITE);
  display.setCursor(0, 30);
  delay(5000);
}
