hydronyme/trr2026/report/build_report/img/1000031770.jpg

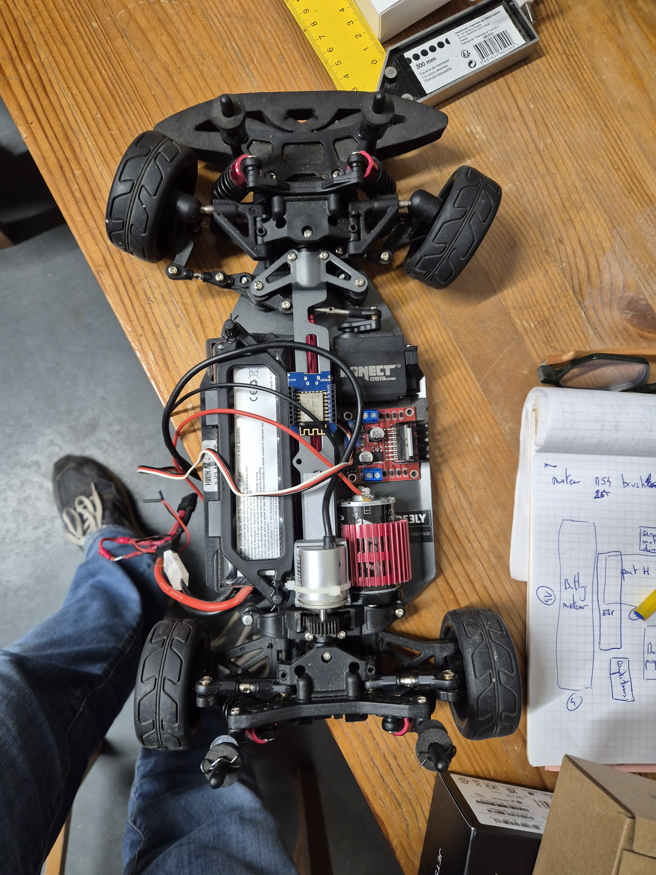
[picture p4: report/build_report/img/1000031770.jpg]
report/build_report/img/1000031770.jpg
