hydronyme/trr2026/report/build_report/img/20260219_164402.jpg

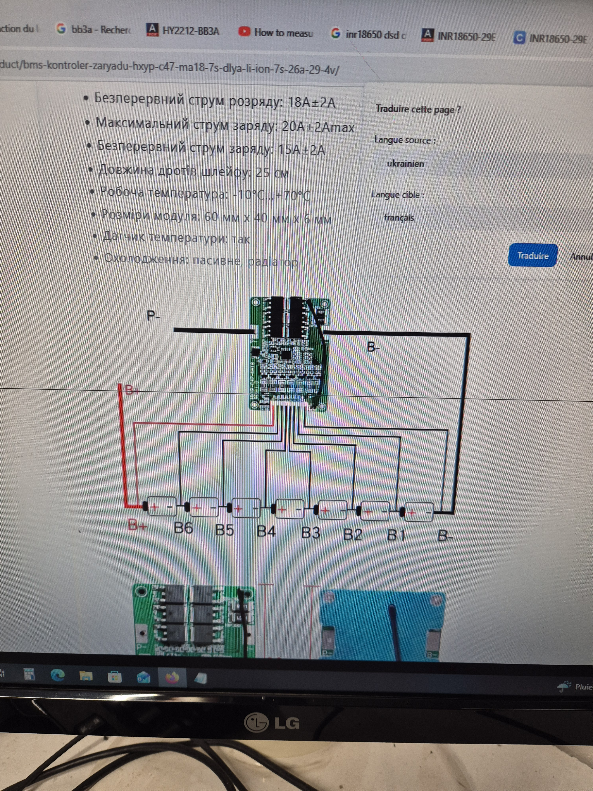
report/build_report/img/20260219_164402.jpg
