hydronyme/trr2026/report/build_report/img/20260219_190843.jpg

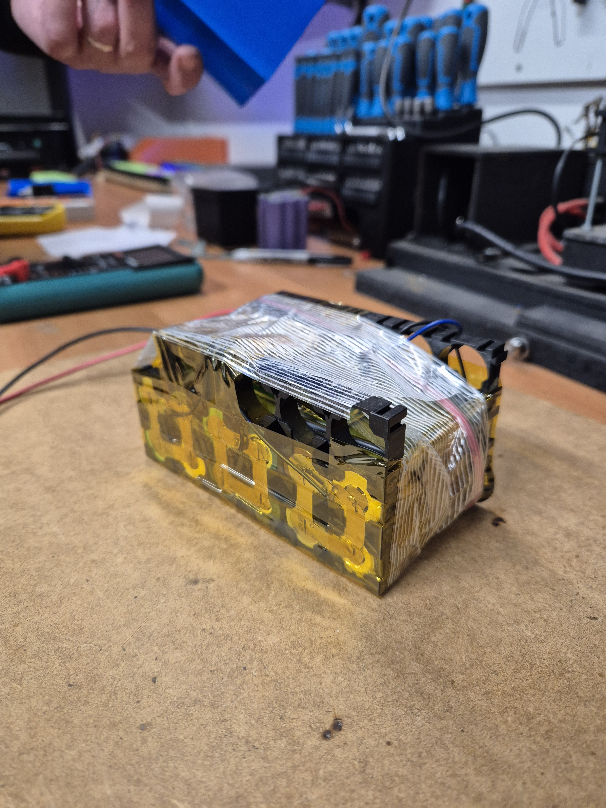
report/build_report/img/20260219_190843.jpg
