hydronyme/trr2026/report/build_report/img/20260305_213113.jpg

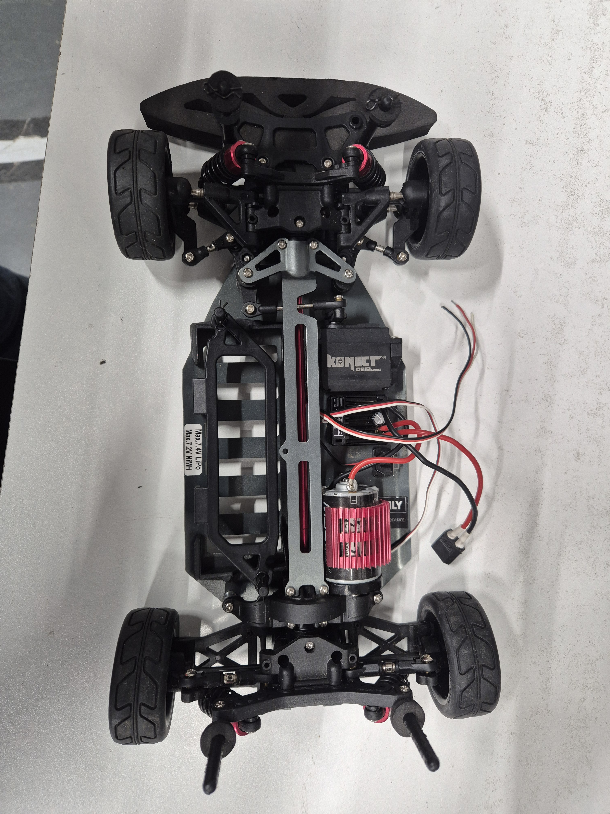
report/build_report/img/20260305_213113.jpg
